Tayyab-Tahir1/Prepaid-Energy-Meter-with-Home-Automation-and-Peak-Load-Management/controller circuit.jpg

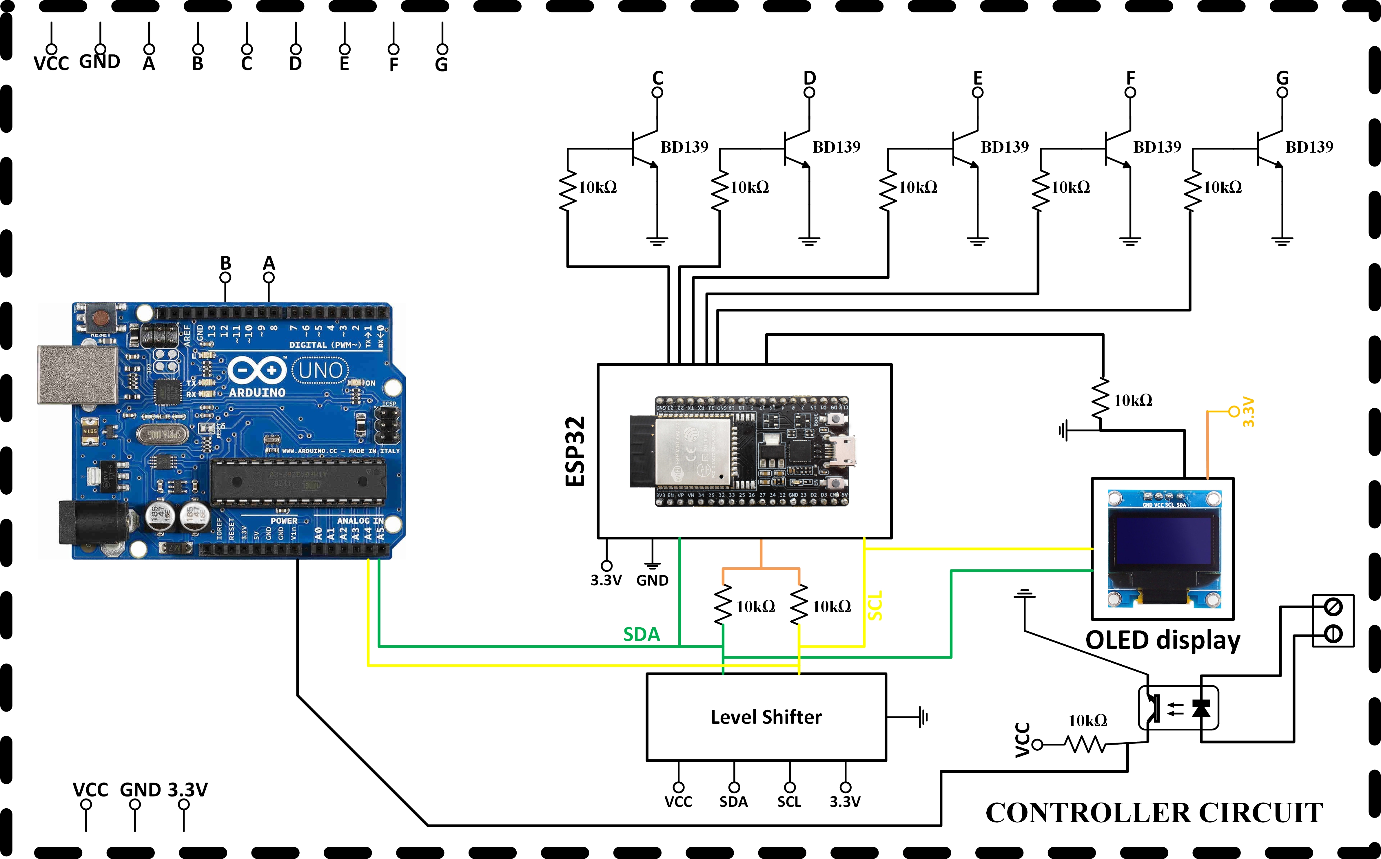
controller circuit.jpg
