Tayyab-Tahir1/Prepaid-Energy-Meter-with-Home-Automation-and-Peak-Load-Management/high voltage circuit.jpg

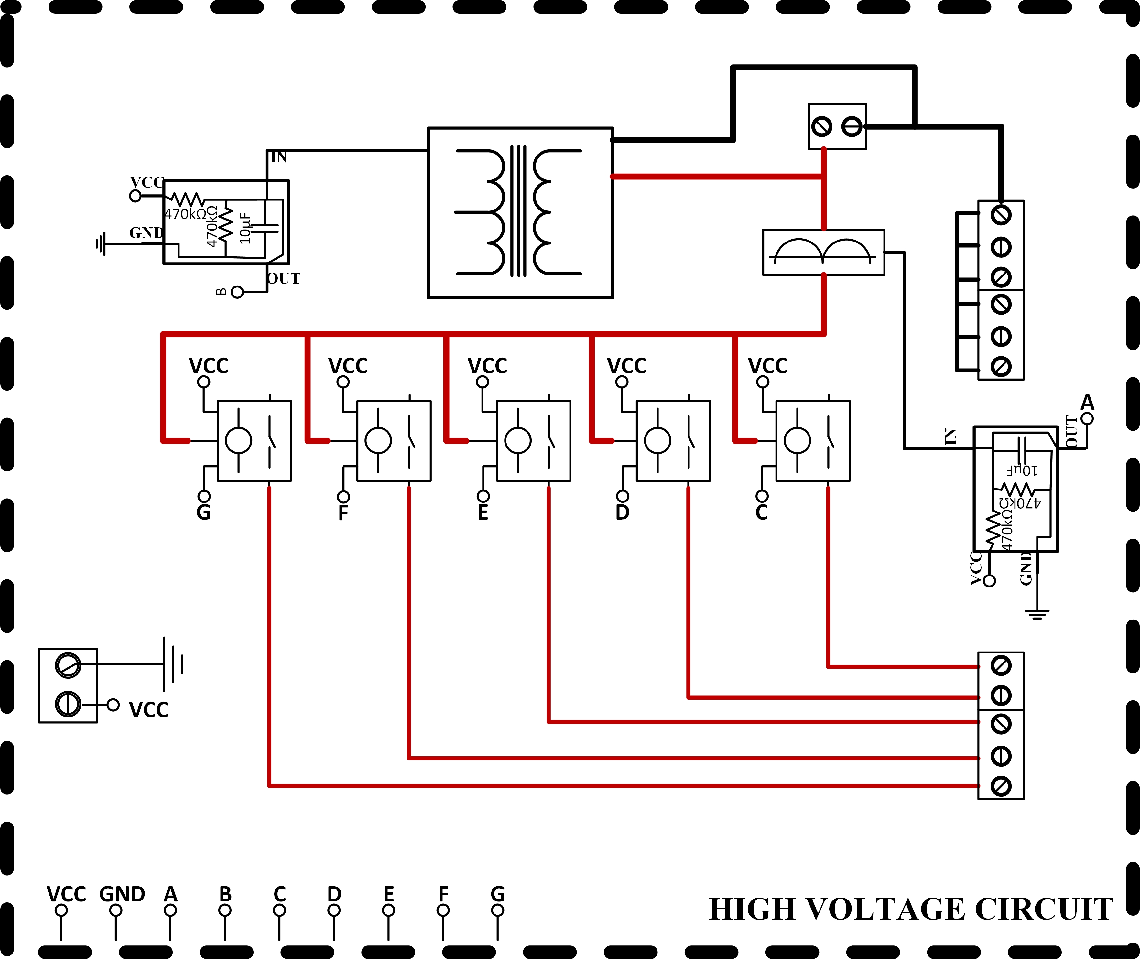
high voltage circuit.jpg
