Tayyab-Tahir1/Prepaid-Energy-Meter-with-Home-Automation-and-Peak-Load-Management/power supply circuit.jpg

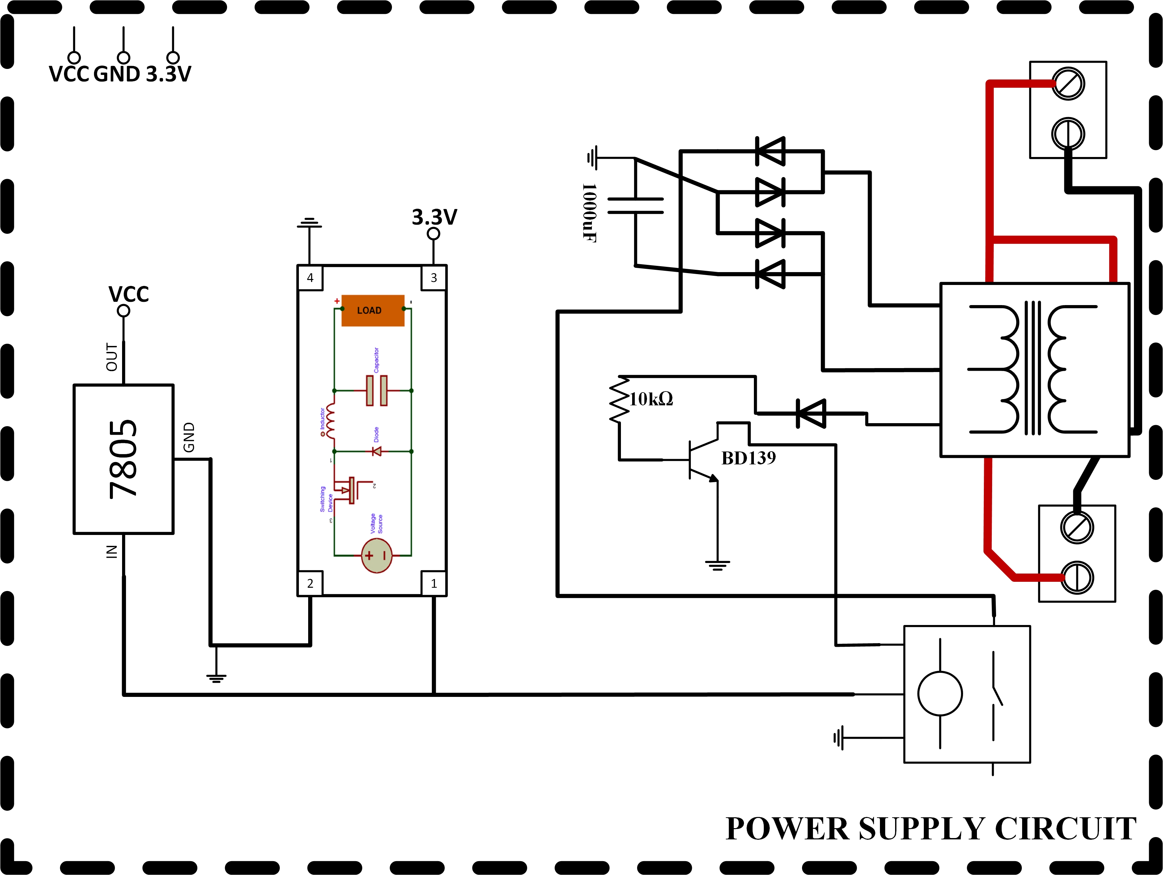
power supply circuit.jpg
