Tayyab-Tahir1/Prepaid-Energy-Meter-with-Home-Automation-and-Peak-Load-Management/(list of files, drawings)

Other design files:
Simulation/Current_sensors.pdsprj
Simulation/PF_measurement.pdsprj
Simulation/power_quantities.pdsprj
Simulation/three_current_sensors.pdsprj
