Tayyab-Tahir1/Prepaid-Energy-Meter-with-Home-Automation-and-Peak-Load-Management/ESP32/time_fetch/time_fetch.ino

#include <WiFi.h>
#include "time.h"

const char* ssid       = "Wi_Fi";
const char* password   = "PaK@$%6141304";

const char* ntpServer = "pk.pool.ntp.org";
const long  gmtOffset_sec = 3600;
const int   daylightOffset_sec = 3600;

void printLocalTime()
{
  struct tm timeinfo;
  if(!getLocalTime(&timeinfo)){
    Serial.println("Failed to obtain time");
    return;
  }
  int time_data = timeinfo.tm_hour + 3;
  //Serial.println(&timeinfo, "%A, %B %d %Y %H:%M:%S");
  Serial.println(time_data);
}

void setup()
{
  Serial.begin(115200);
  
  //connect to WiFi
  Serial.printf("Connecting to %s ", ssid);
  WiFi.begin(ssid, password);
  while (WiFi.status() != WL_CONNECTED) {
      delay(500);
      Serial.print(".");
  }
  Serial.println(" CONNECTED");
  
  //init and get the time
  configTime(gmtOffset_sec, daylightOffset_sec, ntpServer);
  printLocalTime();

  //disconnect WiFi as it's no longer needed
  WiFi.disconnect(true);
  WiFi.mode(WIFI_OFF);
}

void loop()
{
  delay(1000);
  printLocalTime();
}
