Tayyab-Tahir1/Prepaid-Energy-Meter-with-Home-Automation-and-Peak-Load-Management/ESP32/wifi_manager_firebase/wifi_manager_firebase.ino

#include <WiFiManager.h> // https://github.com/tzapu/WiFiManager
#include <FirebaseESP32.h>

#define FIREBASE_HOST "https://bidirectionalmeter-caa0e-default-rtdb.firebaseio.com/"
#define FIREBASE_AUTH "1OVJXsPzdd0J5nSuF2oZ7g3HKbdCxbkyJwVBjxPa"
FirebaseData firebaseData;

float exportEnergy = 0;

void setup() {
    WiFi.mode(WIFI_STA); // explicitly set mode, esp defaults to STA+AP
    // it is a good practice to make sure your code sets wifi mode how you want it.

    // put your setup code here, to run once:
    Serial.begin(115200);
    
    //WiFiManager, Local intialization. Once its business is done, there is no need to keep it around
    WiFiManager wm;

    // reset settings - wipe stored credentials for testing
    // these are stored by the esp library
    //wm.resetSettings();

    // Automatically connect using saved credentials,
    // if connection fails, it starts an access point with the specified name ( "AutoConnectAP"),
    // if empty will auto generate SSID, if password is blank it will be anonymous AP (wm.autoConnect())
    // then goes into a blocking loop awaiting configuration and will return success result

    bool res;
    // res = wm.autoConnect(); // auto generated AP name from chipid
    // res = wm.autoConnect("AutoConnectAP"); // anonymous ap
    res = wm.autoConnect("Smart Energy Meter","16003019006"); // password protected ap

    if(!res) {
        Serial.println("Failed to connect");
        // ESP.restart();
    } 
    else {
        //if you get here you have connected to the WiFi    
        Serial.println("connected...yeey :)");
    }

    Firebase.begin(FIREBASE_HOST, FIREBASE_AUTH);
    Firebase.reconnectWiFi(true);

    

}

void loop() {
    if (Firebase.getFloat(firebaseData, "/exportKwh")) {
    exportEnergy = firebaseData.floatData();
    Serial.println(exportEnergy);
    }
    delay(1000);
}
