Tayyab-Tahir1/Prepaid-Energy-Meter-with-Home-Automation-and-Peak-Load-Management/Arduino/OLED_animation_Pulse_volt_current/graphics.c

#include <avr/pgmspace.h>

const uint8_t frame_00 [] PROGMEM= {
0x00, 0x00, 0x00, 0x00, 0x00, 0x00, 0x00, 0x00, 0x00, 0x00, 0x00, 0x00, 0x00, 0x00, 0x00, 0x00,
0x00, 0x00, 0x80, 0xC0, 0xE0, 0xF0, 0xF0, 0x78, 0x38, 0x38, 0x38, 0x38, 0x38, 0x78, 0xF0, 0xF0,
0xE0, 0xC0, 0x00, 0x00, 0x00, 0x00, 0x00, 0x00, 0x00, 0x00, 0x00, 0x00, 0x00, 0x00, 0x00, 0x00,
0x00, 0x00, 0x00, 0x00, 0x00, 0x00, 0x00, 0x00, 0x00, 0x00, 0x00, 0x00, 0x00, 0x00, 0x00, 0x00,
0x00, 0x00, 0x00, 0x00, 0x00, 0x00, 0x00, 0x00, 0x00, 0x00, 0x00, 0x00, 0x00, 0x00, 0x00, 0x00,
0x00, 0x3C, 0xFF, 0xFF, 0xFF, 0x81, 0x00, 0x3C, 0x7E, 0xE7, 0xC3, 0xE7, 0x7E, 0x3C, 0x00, 0x81,
0xFF, 0xFF, 0xFF, 0x3C, 0x00, 0x00, 0x00, 0x00, 0x00, 0x00, 0x00, 0x00, 0x00, 0x00, 0x00, 0x00,
0x00, 0x00, 0x00, 0x00, 0x00, 0x00, 0x00, 0x00, 0x00, 0x00, 0x00, 0x00, 0x00, 0x00, 0x00, 0x00,
0x00, 0x00, 0x00, 0x00, 0x00, 0x00, 0x00, 0x00, 0x00, 0x00, 0x00, 0x00, 0x00, 0x00, 0x00, 0x00,
0x00, 0x00, 0x01, 0x03, 0xCF, 0xFF, 0xFF, 0xFE, 0xFC, 0xFC, 0xFC, 0xFC, 0xFC, 0xFE, 0xFF, 0xFF,
0xFF, 0x03, 0x00, 0x00, 0x00, 0x00, 0x00, 0x00, 0x00, 0x00, 0x00, 0x00, 0x00, 0x00, 0x00, 0x00,
0x00, 0x00, 0x00, 0x00, 0x00, 0x00, 0x00, 0x00, 0x00, 0x00, 0x00, 0x00, 0x00, 0x00, 0x00, 0x00,
0x00, 0x00, 0x00, 0x00, 0x00, 0x80, 0xC0, 0xE0, 0xF0, 0xF0, 0x70, 0x70, 0x70, 0x70, 0x78, 0xF8,
0xF8, 0xF8, 0xFC, 0xFE, 0xFF, 0xFF, 0xFF, 0xFF, 0xE1, 0xC1, 0xC0, 0xC1, 0xE1, 0xFF, 0xFF, 0xFF,
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
0xF0, 0xF0, 0xF8, 0xF8, 0xF8, 0xF8, 0x7C, 0x7C, 0x7C, 0x3C, 0x3C, 0x3C, 0x3C, 0x3C, 0x3C, 0x3F,
0x3F, 0x3F, 0x3C, 0x3C, 0x3C, 0x3C, 0x3C, 0x3C, 0x7C, 0x7C, 0x7C, 0x7C, 0xF8, 0xF8, 0xF8, 0xF8,
0xF0, 0xF0, 0xE0, 0xC0, 0x00, 0x80, 0xC0, 0xE0, 0xF0, 0xF0, 0xF8, 0xF8, 0xF8, 0xF8, 0xFD, 0x7D,
0x7C, 0x7C, 0x3C, 0x3C, 0x3C, 0x3C, 0x3C, 0x3C, 0x3C, 0x3C, 0x3C, 0x3C, 0x3C, 0x3C, 0x3C, 0x3C,
0x3C, 0x7C, 0x7C, 0x7C, 0xFC, 0xFC, 0xF8, 0xF8, 0xF8, 0xF8, 0xF0, 0xF0, 0xC0, 0x00, 0x00, 0x00,
0x00, 0xFF, 0xFF, 0x00, 0xFF, 0xFF, 0xFF, 0xFF, 0xFF, 0xFF, 0xFF, 0xFF, 0x00, 0x00, 0x00, 0x00,
0x00, 0x00, 0x00, 0x00, 0x00, 0x01, 0x03, 0x07, 0x1C, 0x30, 0x60, 0xC0, 0x80, 0x00, 0x01, 0x07,
0x0C, 0xFF, 0xFF, 0x00, 0x00, 0xFF, 0xFF, 0xFF, 0xFF, 0x3F, 0x01, 0xE0, 0xFF, 0xFF, 0xFF, 0xFF,
0xFF, 0xFF, 0xFF, 0x0F, 0x01, 0xC0, 0xC0, 0x42, 0x81, 0x01, 0xE1, 0xF1, 0x31, 0x11, 0x21, 0xC1,
0x01, 0xE1, 0x31, 0x11, 0x11, 0xE1, 0x03, 0xC3, 0xC3, 0x4E, 0xFE, 0xFC, 0x00, 0x03, 0xFF, 0xFF,
0xFF, 0xFF, 0x0F, 0x00, 0xFC, 0xFF, 0xFF, 0xFF, 0xFF, 0xFF, 0xFF, 0xFF, 0x03, 0x40, 0x38, 0x1E,
0x0E, 0x03, 0x01, 0x01, 0x81, 0xE1, 0x71, 0x19, 0x0F, 0x07, 0x01, 0x01, 0x01, 0x01, 0x01, 0x03,
0x03, 0x07, 0x3E, 0x3E, 0x20, 0x23, 0x27, 0x27, 0x27, 0x27, 0x27, 0x27, 0x27, 0x27, 0x00, 0x00,
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
};
